0x0lor1n/atx-watchdog/docs/poc/schematic.png

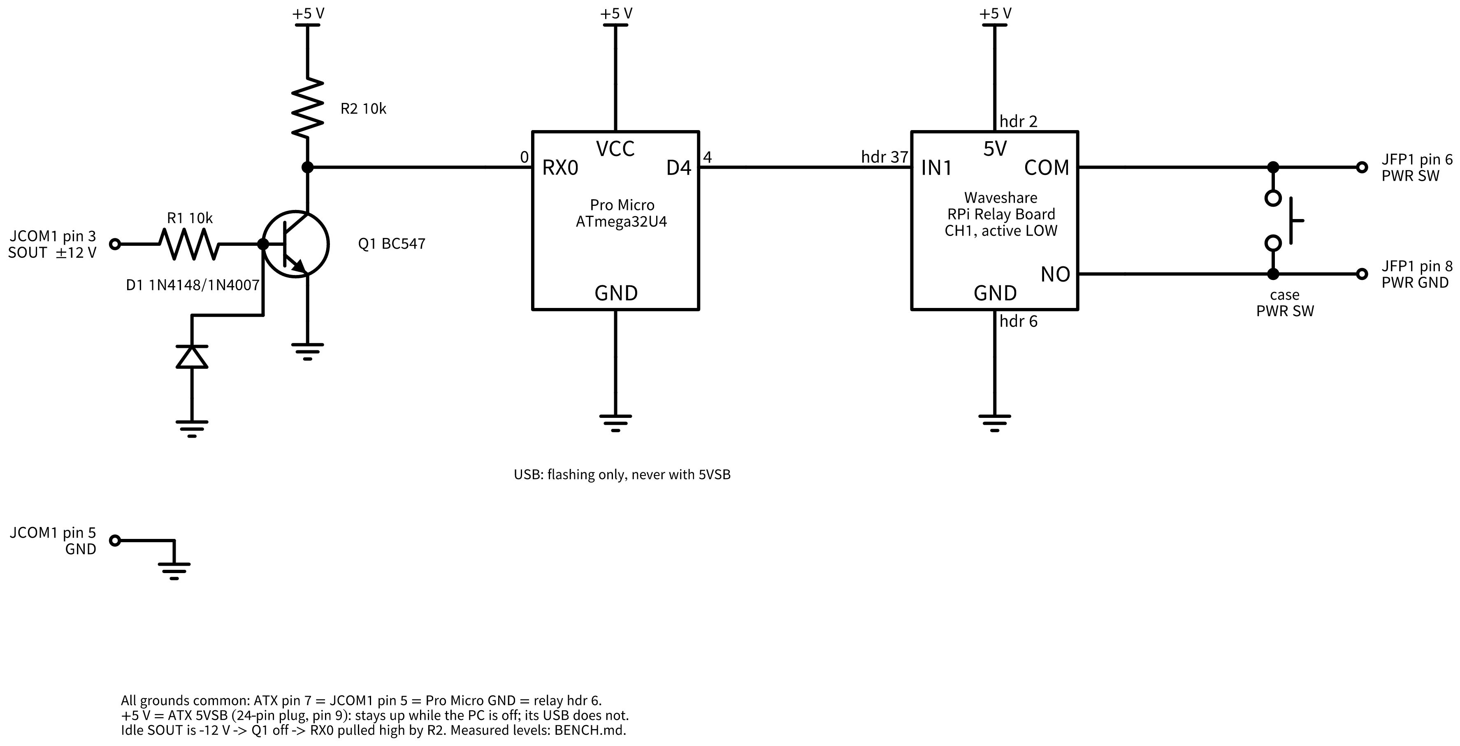
docs/poc/schematic.png
