0x0lor1n/atx-watchdog/docs/final/wiring.png

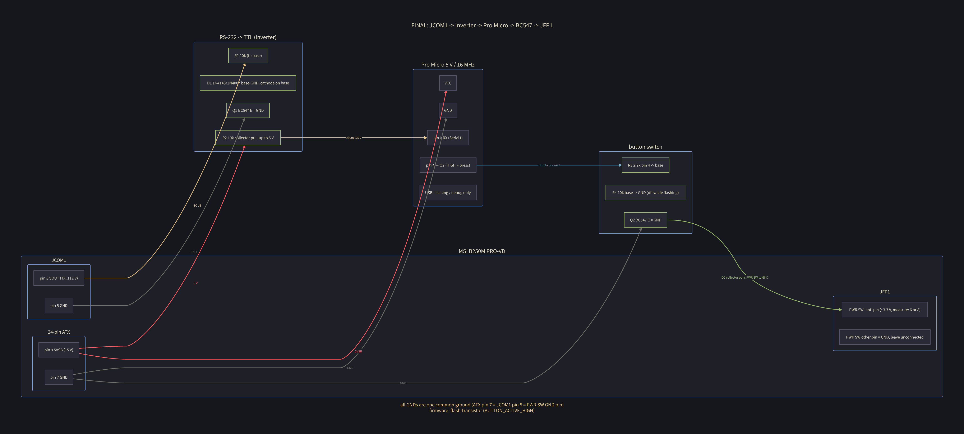
docs/final/wiring.png
