0x0lor1n/atx-watchdog/docs/poc/wiring.png

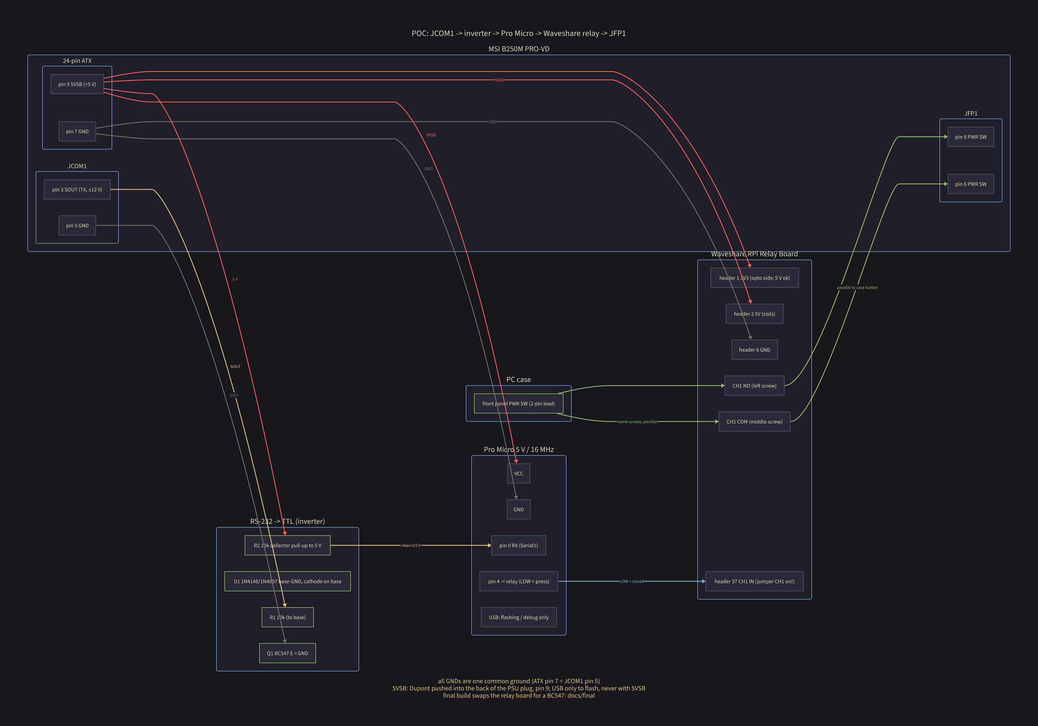
docs/poc/wiring.png
