0x0lor1n/atx-watchdog/docs/schemas/pirelay/RPi-Relay-Board-Schematic.pdf

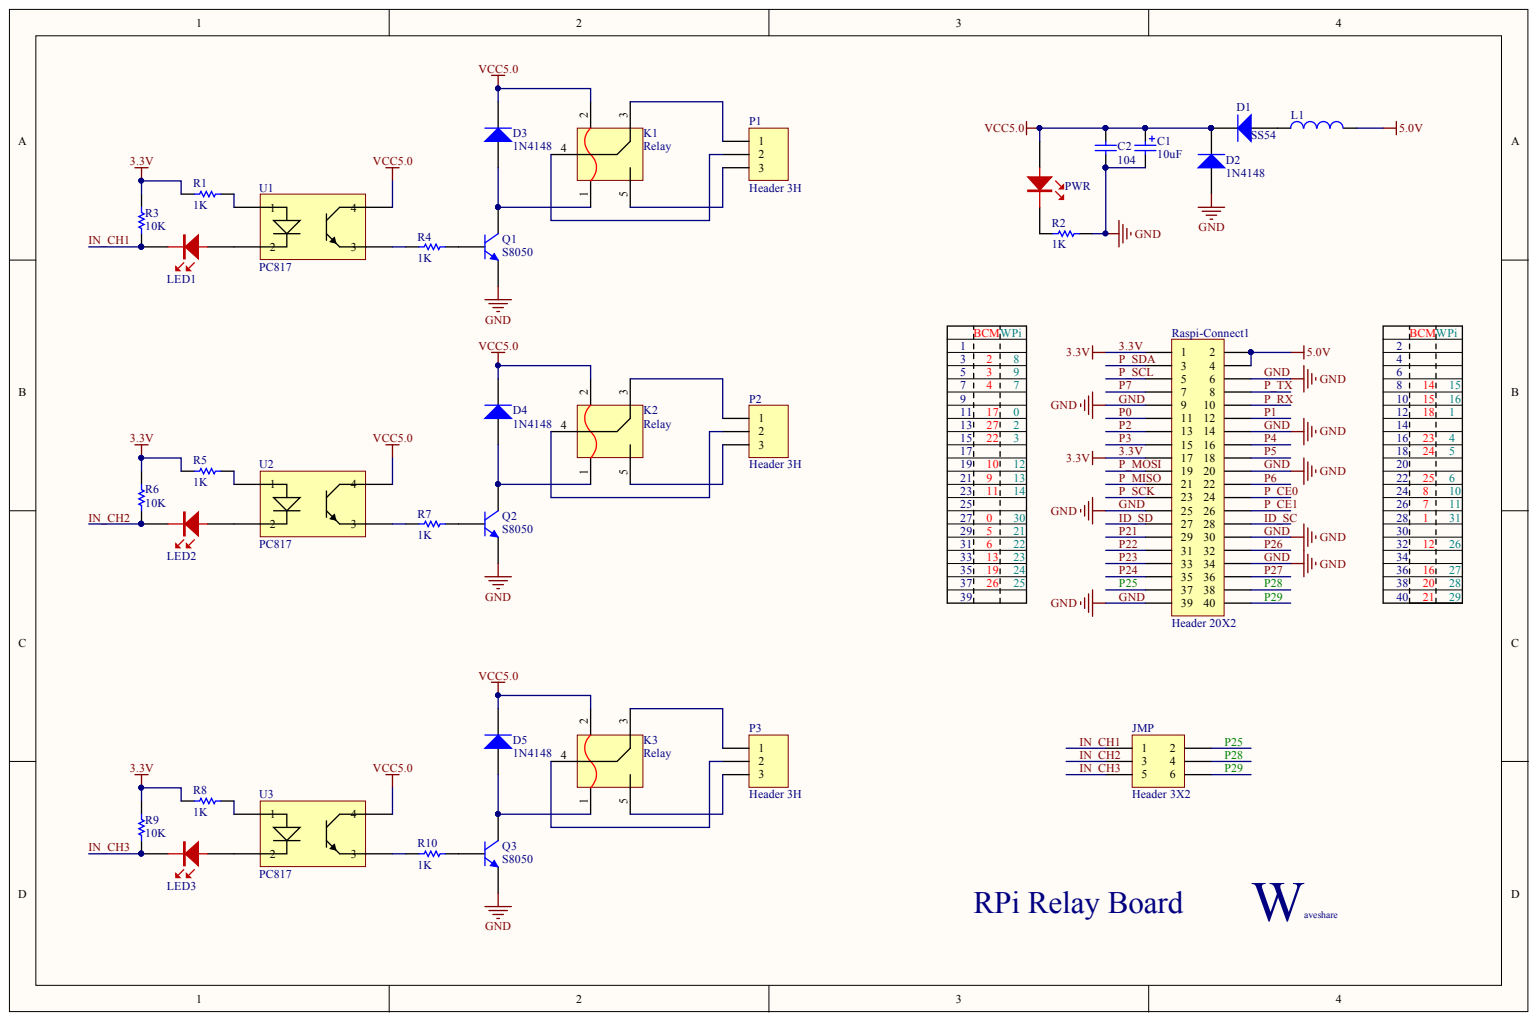
[picture p7: page 1]
