0x0lor1n/atx-watchdog/(list of files, drawings)

Other design files:
docs/final/bench.fzz
docs/poc/bench.fzz
