0x0lor1n/atx-watchdog/(commit log)

2026-10-15 nas-power-button: Pro Micro power button on JCOM1
    Firmware, NixOS module, Fritzing bench sketches and a VM test.
    Module: shutdown hook sends POWEROFF/REBOOT from the shutdown ramfs; a
    heartbeat service sends ALIVE and the firmware power-cycles after 5 min of
    silence. Before each ALIVE the system is probed (is-system-running, synced
    write to probeDirs), and oops / soft lockup / hung task are turned into a
    panic, so a half-dead kernel goes silent too. kernel.panic stays 0: the PCH
    cannot reboot, silence on the port is the signal.
2026-10-16 bench A1: relay board needs header pin 1 and the CH1 jumper
2026-10-16 docs: vendor schematics, poc/final wiring + bench, README; devshell commands
    - docs/schemas/{pirelay,promicro}: Waveshare and SparkFun PDFs with source
    links and the pins that matter
    - docs/poc, docs/final: wiring.d2 (+svg) and the Fritzing bench sketch
    - firmware/poc/firmware.ino, BENCH.md -> docs/
    - devshell: flash-relay, flash-transistor, fizzel-poc, fizzel-final, d2
    - README: why, install, generated+linted breadboards, hardware-free tests,
    mistakes log
2026-10-16 devshell: print available commands on entry
2026-10-16 comments: keep only what the code cannot say
    Removed narration (what the code does, test-step captions, section
    banners, the build story in file headers). Kept vendor facts and traps:
    Caterina re-enumeration, PCH 4 s override, relay header 1, Fritzing
    saving what the GUI moved, QEMU -serial ordering.
    README: "USB controller of the motherboard", stray "TX e".
    BENCH: no personal host names or "I will do it" steps.
    .direnv was tracked; now ignored.
    nix flake check: sim, vm, bench-lint, fritzing pass.
2026-10-16 Add schemdraw schematic for the PoC
    docs/poc/wiring.d2 shows where wires go on the bench; it is not a
    schematic. schematic/poc.py draws the circuit itself: SOUT -> R1/D1 ->
    Q1 -> R2 pull-up -> RX0, D4 -> relay IN1, COM/NO across JFP1 PWR SW.
    `nix build .#schematic` regenerates docs/poc/schematic.svg, which is
    tracked so the README link works without a build.
    The final stage stays on d2 for now; KiCad is the next thing to try.
2026-10-16 Add lefthook pre-commit hooks; render schematic text as paths
    Lint tools come from the devshell; shellHook installs the hooks.
    schemdraw text="path" so pin labels sit where the generator put them
    in every viewer, not where the viewer's fallback font puts them.
2026-10-16 docs: PNG next to every drawing, render-docs, docs-fresh check
    Telegram's preview dropped the schemdraw text (glyphs via <use>) and d2's
    embedded @font-face, so the SVGs were useless in chat. One nix derivation
    now renders svg+png for the schematic and both wiring diagrams; resvg gets
    Source Sans for the d2 text and a white canvas for the schematic.
    The d2 canvas was white under a theme picked for dark GitHub, so the title
    and notes were near-invisible there too. Dark root fill, bigger pin font.
    render-docs copies the build into docs/; the docs-fresh check fails
    nix flake check (pre-push) if a tracked SVG drifts from its source.
    PNGs are not compared: resvg output is not byte-stable across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
2026-10-16 Three top-level dirs: docs, src, test
    Sources move under src/{firmware,fritzing,schematic}; the poc/ level under
    firmware goes, one sketch serves both builds. README drops the command
    list and the layout table, the devshell banner is the source of truth.
2026-10-17 Relay board: real channel and terminal order
    Channels run CH3, CH2, CH1 left to right and CH1's terminals NO, COM,
    NC, checked with a meter on the board. The drawing guessed both; the
    bench wired JFP1 to CH3 COM/NC and the button sat pressed. README
    records the mistake, BENCH.md the order and the continuity check.
2026-10-18 Drop serial input that arrives while the button is down
    A watchdog hold reaches a live OS as a short press first; logind shut the
    NAS down and its queued POWEROFF ran after the power cycle, switching the
    freshly booted NAS off again.
2026-10-18 direnv: rebuild the devshell when src/ changes
    flash-relay bakes the firmware in; without the watch it flashed the build
    from when the shell was entered.
2026-10-18 Case power button and 5VSB feed in schematic, wiring and bench
2026-10-18 README: watchdog protocol and COM commands, next steps; MIT license; BENCH: stage A done
2026-10-18 Move the Fritzing generator into the fzgen package
    src/fzgen is a pyproject package built with buildPythonPackage and put
    into the shared python env: Sketch (placement, net tracing, .fzz writer),
    GenPart, svgpins, core-part placement (span, resistor, npn_to92), the
    SparkFun Pro Micro with its vendored part, fzgen-lint and the mutation
    runner. gen.py keeps only this board's parts, nets and layout; its lint
    mutations move to src/fritzing/lint_cases.py.
    docs/poc and docs/final bench.fzz regenerate byte-identical.
2026-10-18 README: PNG links, PoC bench and in-case photos
2026-10-19 Use mcu-bench for firmware build, flashers, Fritzing, schematics and devshell
2026-10-19 README: link the bench worklog; schematic: drop section banners
